rahul-shahtp/Pipelined-32-bit-RISCV-processor/docs/Klayout_view/2.5d_layout.png

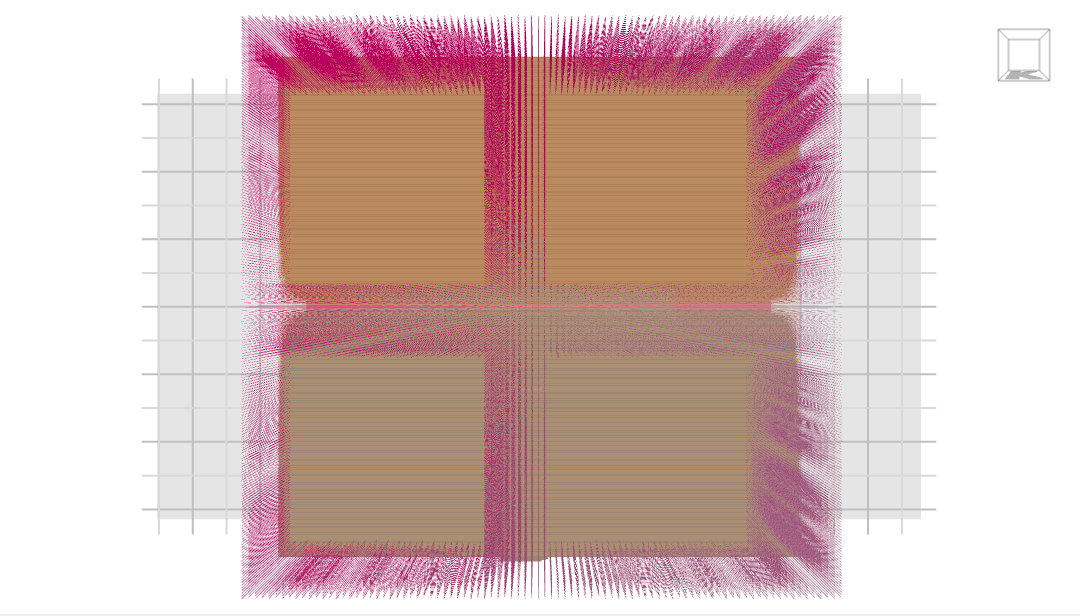
docs/Klayout_view/2.5d_layout.png
