rahul-shahtp/Pipelined-32-bit-RISCV-processor/docs/openROAD_view/layout2.png

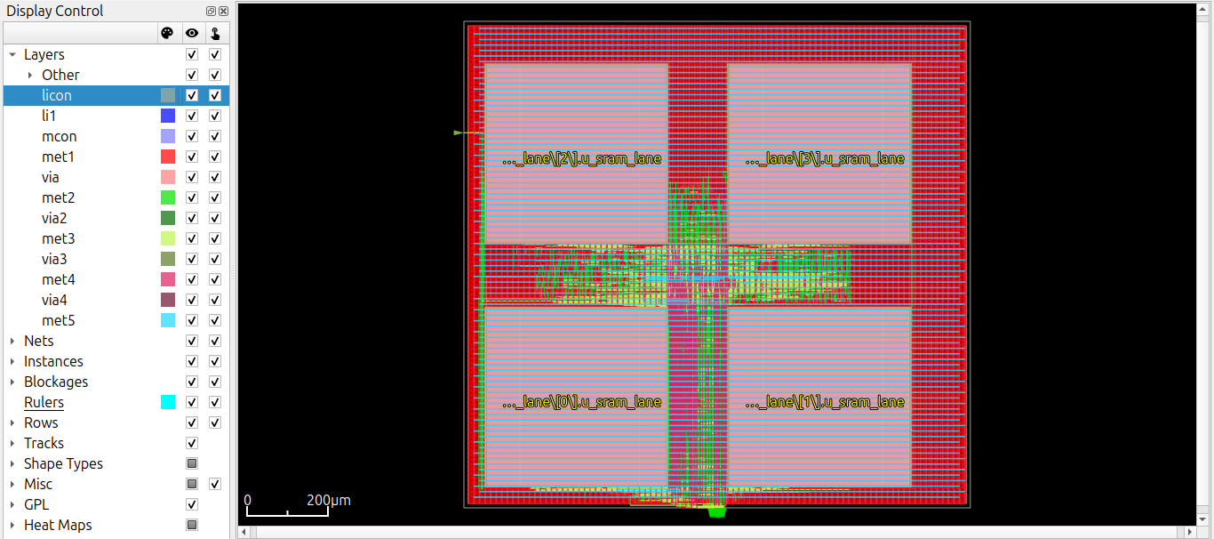
docs/openROAD_view/layout2.png
