rahul-shahtp/Pipelined-32-bit-RISCV-processor/README.md

# Pipelined 32-bit RISC-V (RV32IM) Processor








A complete RTL-to-GDS implementation of a **5-stage pipelined RV32IM core** (RV32I base ISA + M-extension for integer multiplication/division) in Verilog, verified with SystemVerilog testbenches and taken through full physical implementation using the open-source Sky130 PDK.

---

## 📐 Architecture

### Pipeline Stages
| Stage | Function | Key Modules |
|---|---|---|
| **IF** | Instruction Fetch | `pc_reg`, `pc_adder`, `instr_mem`, `if_to_id_reg` |
| **ID** | Decode / Register Read / Hazard Detection | `control_unit`, `register_file`, `imm_gen`, `branch_unit`, `hazard_detection_unit`, `id_to_ex_reg` |
| **EX** | Execute / ALU / Forwarding | `alu`, `alu_control`, `forwarding_unit`, `mul_div_unit`, `ex_to_mem_reg` |
| **MEM** | Memory Access | `data_memory` (4× SRAM macros), `mem_to_wb_reg` |
| **WB** | Writeback | `wb_mux` |

### Key Microarchitectural Features
- **5-stage pipeline** with full bypass/forwarding (ALU operand A & B)
- **Hazard Detection Unit** — load-use stalls (1-cycle bubble)
- **Branch Unit** — early branch resolution in ID; control flush on mispredict
- **M-Extension** — iterative multiplier/divider (`mul_div_unit`) with `mul`, `mulh`, `mulhu`, `div`, `divu`, `rem`, `remu`
- **Byte/Halfword/Word Load-Store** — `LB/LH/LBU/LHU/SB/SH/SW` with sign/zero extension
- **JAL/JALR** — link register support with PC+4 writeback
- **SRAM Integration** — 4× `sky130_sram_1kbyte_1rw1r_8x1024_8` macros (4 KB total, 1 per byte lane)

---

## 🛠 Tools Used

| Category | Tools |
|---|---|
| **Simulation** | Icarus Verilog, GTKWave |
| **Synthesis** | Yosys (Sky130 standard cells) |
| **SRAM Compiler** | OpenRAM (via Sky130 `sky130_sram_macros`) |
| **Physical Implementation** | OpenROAD (floorplan → placement → CTS → routing) |
| **PDK** | Sky130A (sky130_fd_sc_hd + sky130_sram_macros) |
| **Sign-off / View** | Magic, KLayout |

---

## ✅ Verification

SystemVerilog testbench (`tb/rv32im_top_tb.sv`) with **16/16 regression tests passing**:

| Test | Coverage |
|---|---|
| `test_rtype` | ADD, SUB, AND, OR, XOR, SLT, SLTU, SLL, SRL, SRA |
| `test_itype` | ADDI, ANDI, ORI, XORI, SLTI, SLTIU, SLLI, SRLI, SRAI |
| `test_loadstore` | LB, LH, LBU, LHU, SB, SH, SW |
| `test_branch_taken_nottaken` | BEQ, BNE, BLT, BGE, BLTU, BGEU |
| `test_branch_after_alu` | Branch immediately after ALU op (forwarding) |
| `test_load_use` | Load-use stall (1-cycle bubble) |
| `test_raw_back2back` | Back-to-back RAW hazards |
| `test_raw_one_gap` | RAW with one instruction gap |
| `test_jal_jalr` | JAL, JALR with link register |
| `test_lui_auipc` | LUI, AUIPC |
| `test_mul` | MUL, MULH, MULHU |
| `test_div` | DIV, DIVU, REM, REMU (edge cases: div by 0, overflow) |
| `test_x0_writeignore` | x0 hardwired to zero |
| `test_factorial` | Recursive factorial (stress) |
| `test_fibonacci` | Iterative Fibonacci (stress) |
| `test_stress_mixed` | Mixed instruction stream |

Run locally:
```bash
iverilog -g2012 -o sim.out tb/rv32im_top_tb.sv rtl/**/*.v
vvp sim.out
gtkwave dump.vcd
```

---

## 🏗 Physical Implementation

**Flow**: `flow.tcl` (OpenROAD) — synthesis → floorplan → placement → CTS → routing

```bash
# Synthesis (Yosys)
yosys synth_out/sky130_synth.ys

# PnR (OpenROAD)
openroad -no_init -exit flow.tcl
```

### Results

| Metric | Value |
|---|---|
| **Die Area** | 1.5 mm² (1250 × 1200 µm) |
| **Core Utilization** | 62% |
| **Total Instances** | 18,759 (incl. 4 SRAM macros, 8,160 tapcells, 866 endcaps, 290 CTS buffers) |
| **Total Wirelength** | 457k µm |
| **Metal Usage** | met1: 172k, met2: 199k, met3: 50k, met4: 35k, met5: 0.9k µm |
| **Clock Period** | 10 ns (100 MHz target) |
| **WNS (TT, 25°C, 1.8V)** | −2.29 ns |
| **TNS** | −12.6 ns |
| **DRC Violations** | 0 |
| **LVS** | Not yet run |

> **Note on Timing**: Negative WNS (−2.29 ns) indicates setup violations at 100 MHz. This is a physical implementation detail — the processor is functionally correct (16/16 tests pass in simulation). Since this project targets RTL-to-GDS flow exploration rather than physical tapeout, the clock period could be relaxed to ~13 ns (77 MHz) or RTL retiming applied (e.g., moving branch resolution from ID to EX stage).

---

## 🧠 SRAM Macros (OpenRAM)

The data memory is built from **4 × `sky130_sram_1kbyte_1rw1r_8x1024_8`** macros — one per byte lane (4 KB total). These macros are generated by [**OpenRAM**](https://github.com/VLSIDA/OpenRAM), the open-source SRAM compiler. Pre-compiled copies ship with the Sky130 PDK under `sky130_sram_macros`, so no local OpenRAM run is needed to reproduce this flow.

| Property | Value |
|---|---|
| **Macro** | `sky130_sram_1kbyte_1rw1r_8x1024_8` |
| **Organization** | 1024 words × 8-bit (1 KB) |
| **Ports** | 1RW port + 1R port (1RW1R), write mask |
| **Instances** | 4 — one per byte lane of `data_memory` |

### How the macros enter the flow
1. **RTL** — `rtl/mem_stage/sram_1kbyte_1rw1r_8x1024_8_bb.v` provides an empty `(* blackbox *)` model whose pins exactly match the macro LEF (`addr0/addr1`, `din0`, `dout0/dout1`, `csb0/csb1`, `web0`, `wmask0`, `clk0/clk1`, `vccd1/vssd1`).
2. **Synthesis** — Yosys keeps the module as a blackbox; no internal netlist is synthesized.
3. **Place & Route** — `flow.tcl` reads the macro LEF and TT timing lib from the PDK (`libs.ref/sky130_sram_macros/{lef,lib}/…`), then OpenROAD binds the 4 instances to the LEF macro and places them with halos.

### Regenerating macros with OpenRAM (optional)
Only needed if you want a different size/org/port configuration:
```bash
git clone https://github.com/VLSIDA/OpenRAM && cd OpenRAM
# install per repo instructions, then run with a sky130 config file:
openram.py myconfig_sky130.py   # emits .v / .lib / .lef / .gds / .sp
```

---

## 📁 Repository Structure

```
├── ASM/                    # Assembly test programs (.asm)
├── hex/                    # Pre-compiled hex files for simulation
├── rtl/
│   ├── if_stage/           # IF pipeline stage
│   ├── id_stage/           # ID pipeline stage
│   ├── ex_stage/           # EX pipeline stage (ALU, MUL/DIV, forwarding)
│   ├── mem_stage/          # MEM pipeline stage (SRAM, data memory)
│   ├── wb_stage/           # WB pipeline stage
│   └── top/                # Top-level integration (rv32im_top.v, rv32im_asic.v)
├── tb/
│   └── rv32im_top_tb.sv    # SystemVerilog testbench (16 tests)
├── synth/
│   └── sky130_synth.ys     # Yosys synthesis script
├── flow.tcl                # OpenROAD PnR flow script
├── docs/
    ├── design/             # Design documentation
    ├── Klayout_view/       # Layout screenshots
    ├── openROAD_view/      # OpenROAD screenshots
    └── waveforms/          # Simulation waveforms
```
---

## 🚀 How to Run

### Prerequisites
- Icarus Verilog (`iverilog`)
- GTKWave (`gtkwave`)
- Yosys + Sky130 PDK
- OpenROAD + Sky130 PDK
- Magic / KLayout (layout viewing)
- OpenRAM (optional — only to recompile custom SRAM macros)

### Simulation
```bash
# Compile & run all tests
iverilog -g2012 -o sim.out tb/rv32im_top_tb.sv rtl/**/*.v
vvp sim.out

# View waveforms
gtkwave dump.vcd
```

### Synthesis (Yosys)
```bash
cd synth
yosys sky130_synth.ys
# Outputs: synth_out/rv32im_asic_sky130.v, rv32im_asic.sdc
```

### Physical Implementation (OpenROAD)
```bash
export PDK_ROOT=/path/to/pdk
openroad -no_init -exit flow.tcl
# Outputs in results/: .def, _route.v, .sdc, .db, timing/area/power reports
```

---

## 🔮 Future Work
- **AI Accelerator Extension** — integrate a systolic-array MAC coprocessor for matrix multiply, connected via memory-mapped I/O to the RV32IM core

---

## 🔗 Project Links

- **OpenCores:** https://opencores.org/projects/rv32im-pipelined (SVN trunk, tag `v1.0-alpha`, LGPL-3.0)
- **Status:** Alpha — 16/16 tests pass, 0 DRC, WNS open (see [LIMITATIONS.md](LIMITATIONS.md))

---

## 📄 License

Copyright © 2026 Rahul Shah <shahrahul@opencores.org>. Licensed under the **GNU Lesser General Public License v3.0** — see [LICENSE](LICENSE) for details.

### How to Apply These Terms to Source Files

If you contribute to or redistribute this software, attach the following notice to each source file (typically at the top):

```verilog
// Pipelined 32-bit RISC-V (RV32IM) Processor — a five-stage pipelined
// Verilog processor core.
// Copyright (C) 2026 Rahul Shah <shahrahul@opencores.org>
//
// This library is free software; you can redistribute it and/or
// modify it under the terms of the GNU Lesser General Public
// License as published by the Free Software Foundation; either
// version 3 of the License, or (at your option) any later version.
//
// This library is distributed in the hope that it will be useful,
// but WITHOUT ANY WARRANTY; without even the implied warranty of
// MERCHANTABILITY or FITNESS FOR A PARTICULAR PURPOSE.  See the GNU
// Lesser General Public License for more details.
//
// You should have received a copy of the GNU Lesser General Public
// License along with this library; if not, write to the Free Software
// Foundation, Inc., 51 Franklin Street, Fifth Floor, Boston, MA  02110-1301  USA
```
