rahul-shahtp/Pipelined-32-bit-RISCV-processor/docs/design/riscvaddress.png

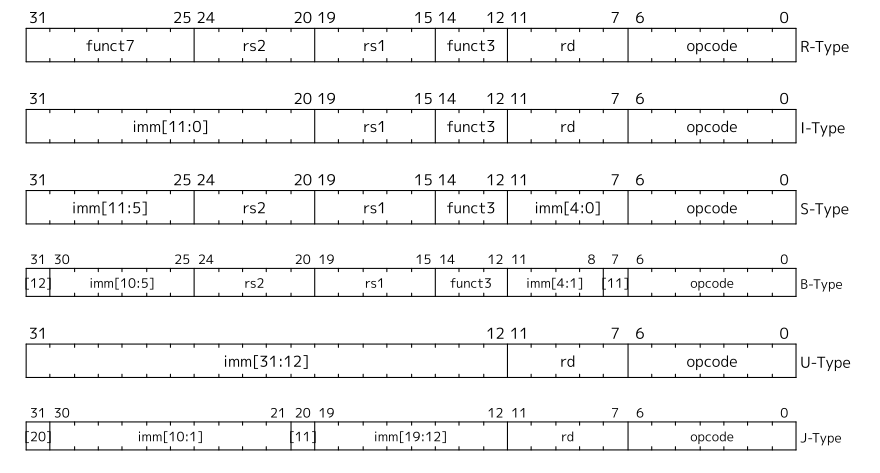
docs/design/riscvaddress.png
