rahul-shahtp/Pipelined-32-bit-RISCV-processor/docs/design/riscvdesign2.png

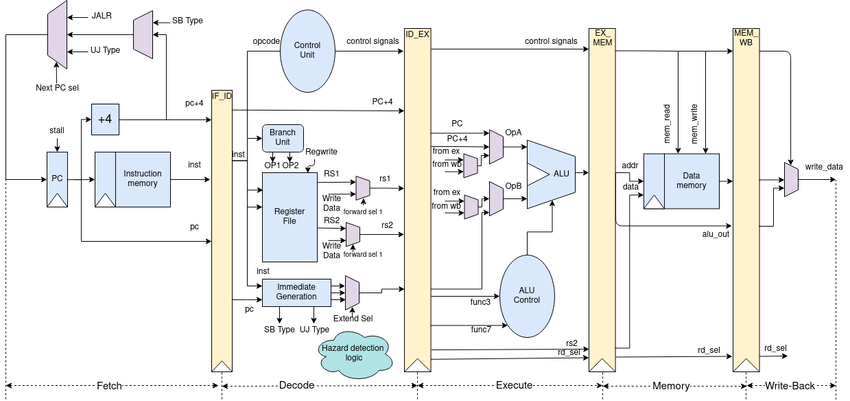
docs/design/riscvdesign2.png
