rahul-shahtp/Pipelined-32-bit-RISCV-processor/docs/design/riscvdesign.png

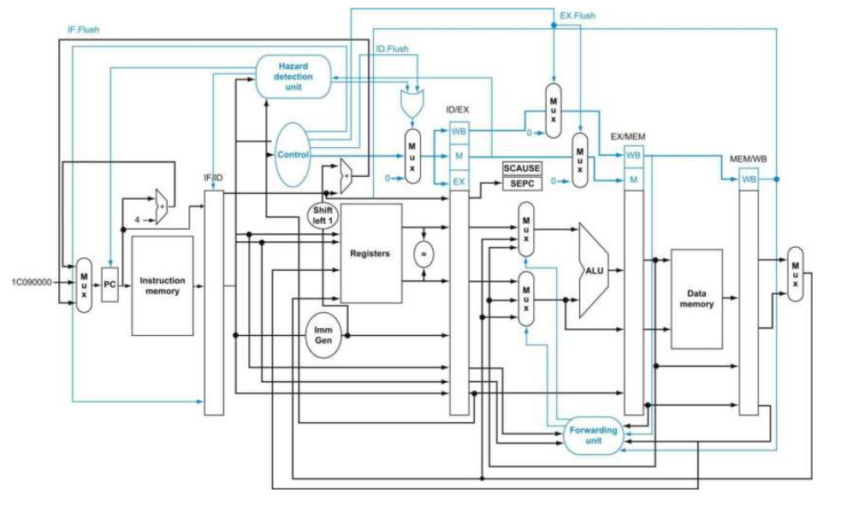
docs/design/riscvdesign.png
