rahul-shahtp/Pipelined-32-bit-RISCV-processor/docs/Klayout_view/full_layout.png

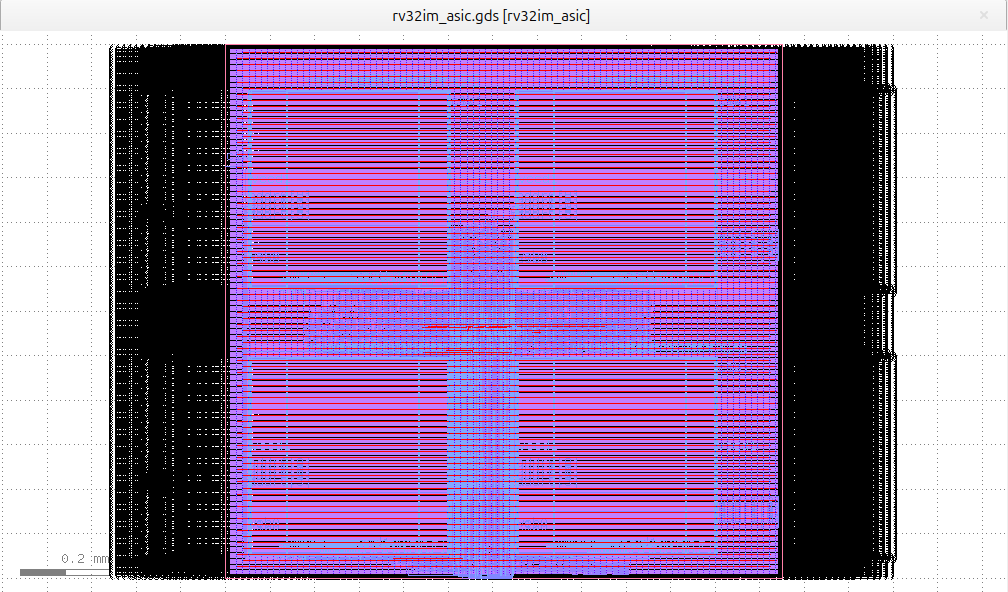
docs/Klayout_view/full_layout.png
