rahul-shahtp/Pipelined-32-bit-RISCV-processor/docs/waveforms/test_branch_after_alu_flush.png

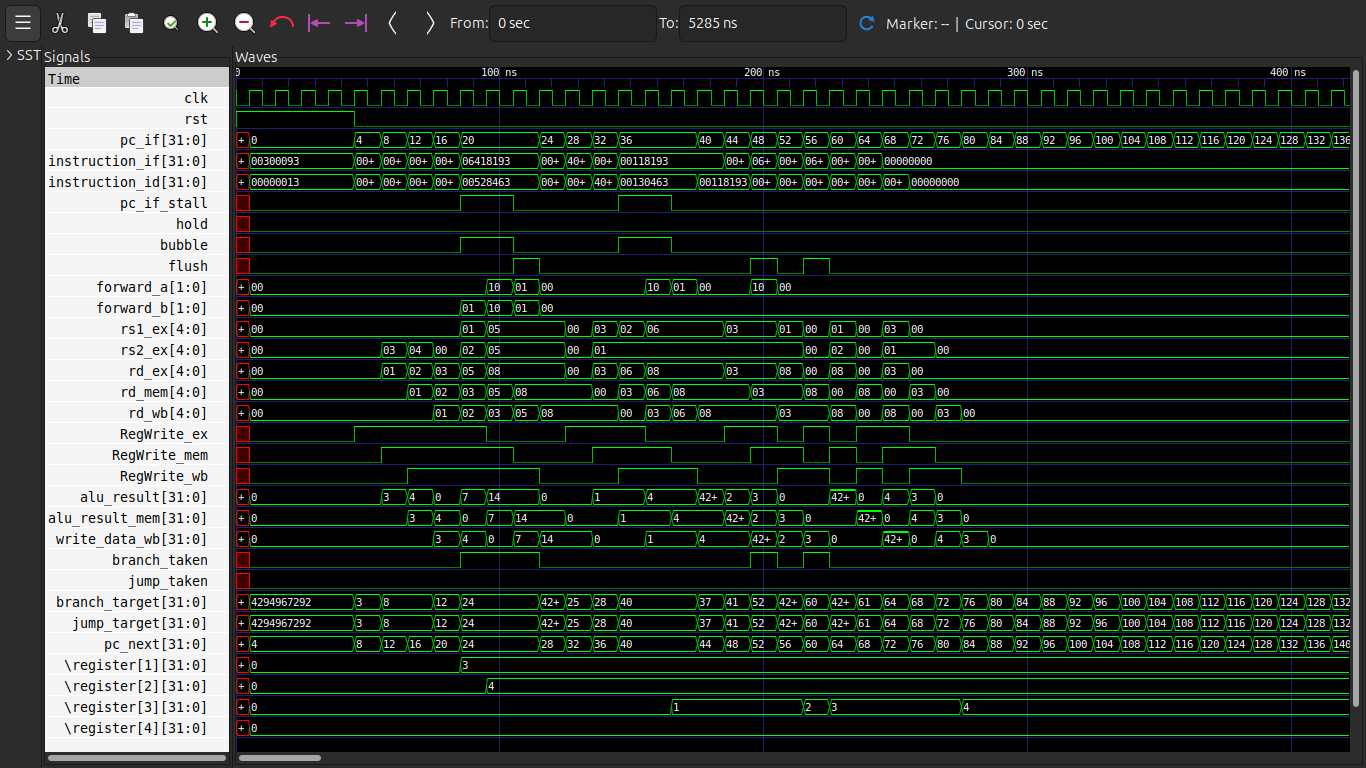
docs/waveforms/test_branch_after_alu_flush.png
