rahul-shahtp/Pipelined-32-bit-RISCV-processor/docs/waveforms/test_fibonacci_forwarding_loop.png

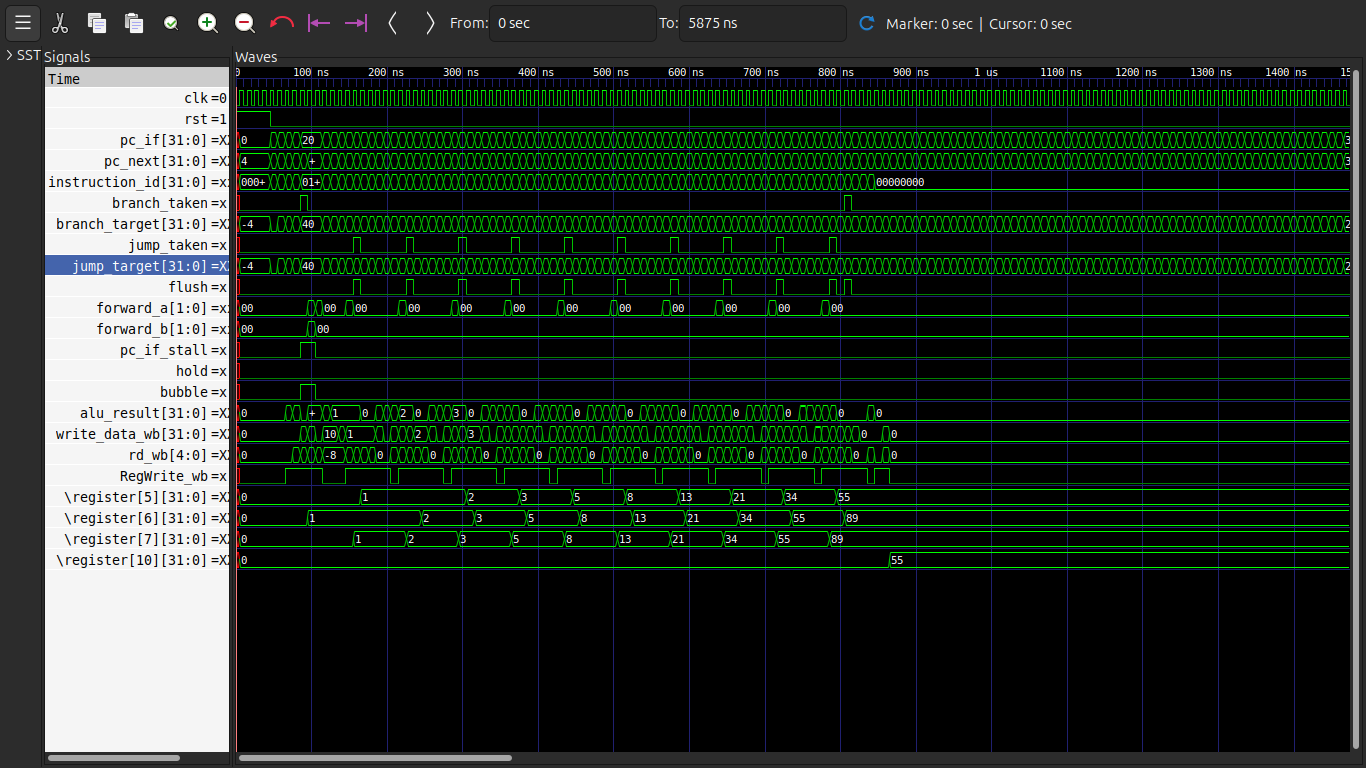
docs/waveforms/test_fibonacci_forwarding_loop.png
