rahul-shahtp/Pipelined-32-bit-RISCV-processor/docs/waveforms/test_jal_jalr_control_flow.png

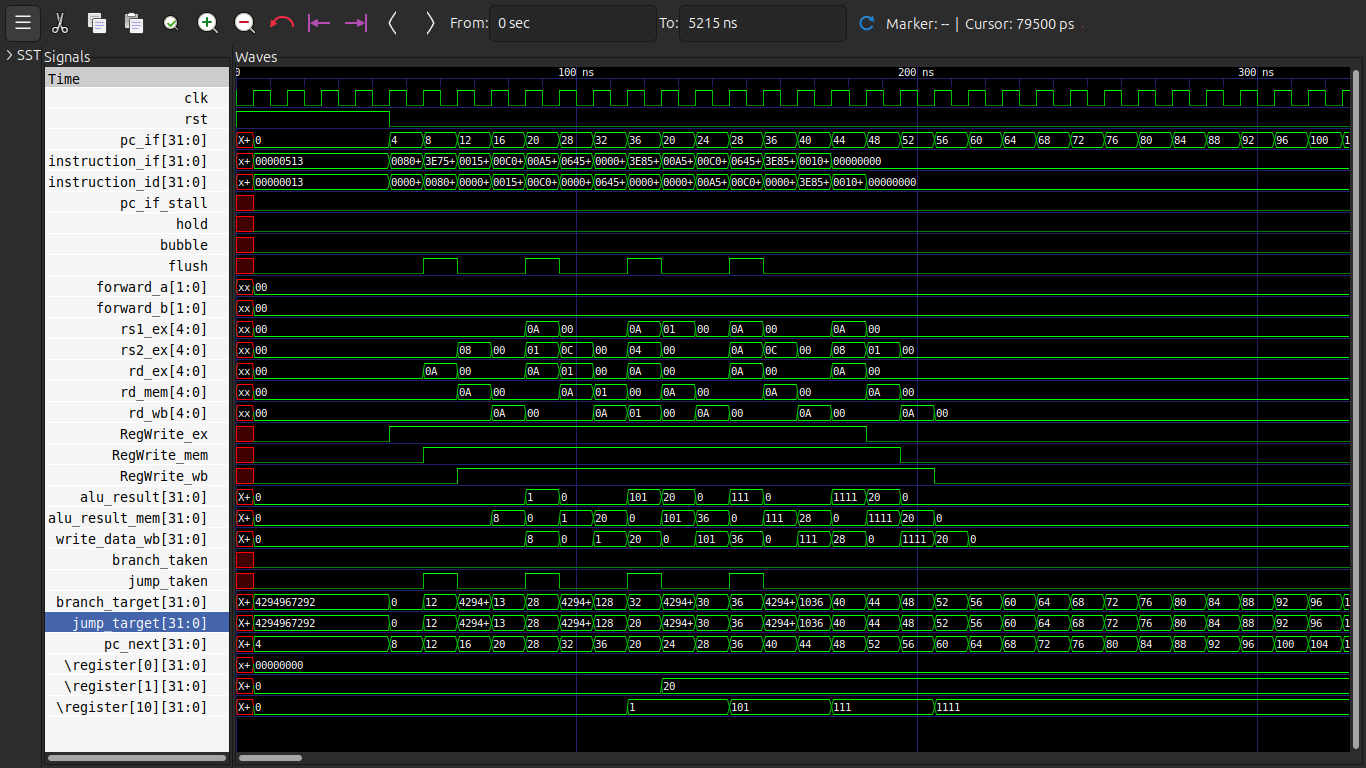
docs/waveforms/test_jal_jalr_control_flow.png
