rahul-shahtp/Pipelined-32-bit-RISCV-processor/docs/waveforms/test_load_use_stall.png

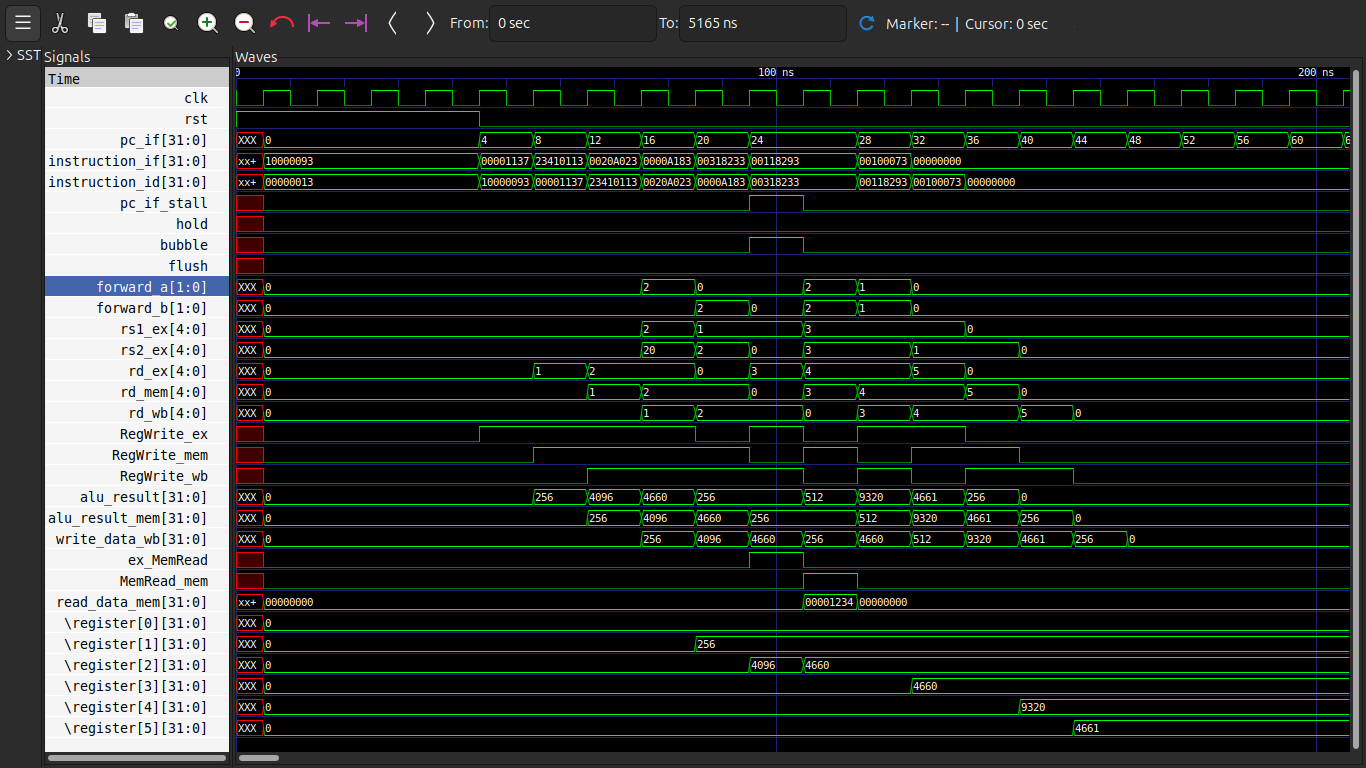
docs/waveforms/test_load_use_stall.png
