rahul-shahtp/Pipelined-32-bit-RISCV-processor/docs/waveforms/test_mul_div_result.png

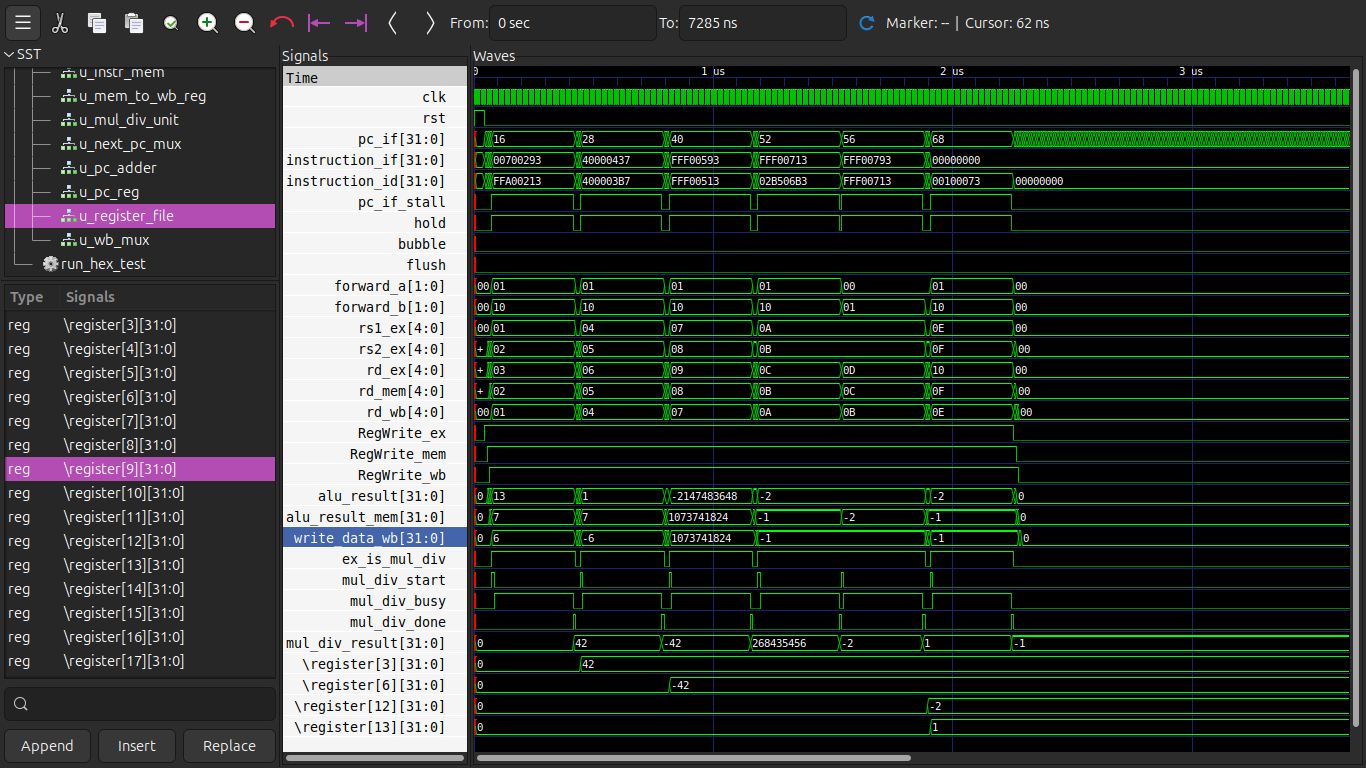
docs/waveforms/test_mul_div_result.png
