rahul-shahtp/Pipelined-32-bit-RISCV-processor/docs/waveforms/test_raw_back2back_forwarding.png

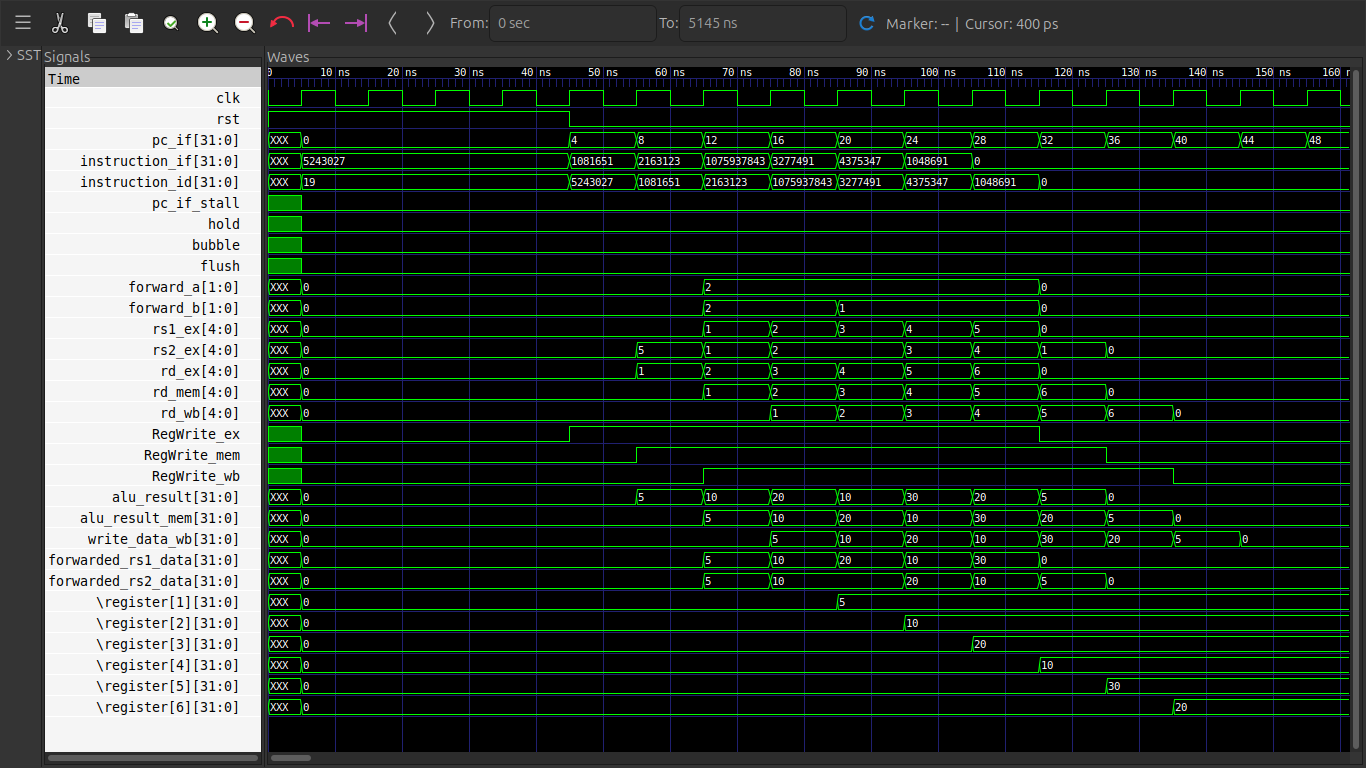
docs/waveforms/test_raw_back2back_forwarding.png
