rahul-shahtp/Pipelined-32-bit-RISCV-processor/docs/design/fullschematic.pdf

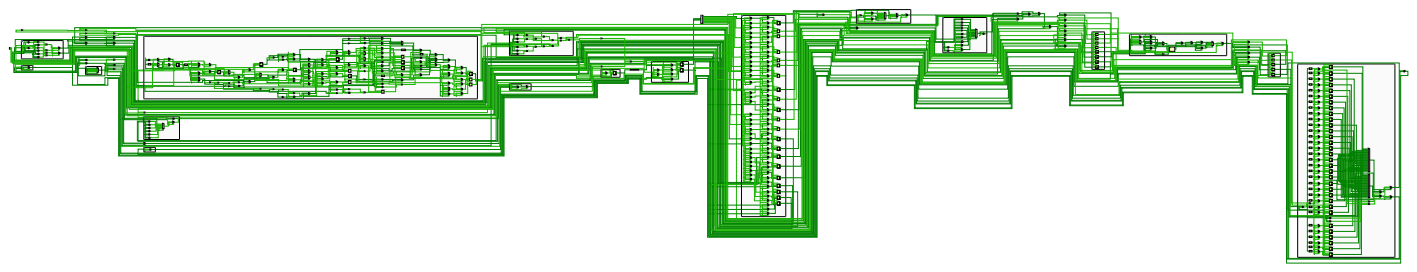
[picture p17: page 1]
u_alu; alu; zero; n/c alu_op[3:0]; alu_result[31:0] operand_a[31:0] operand_b[31:0]; u_alu_control; alu_control; funct7_5thBIT; is_mul_div; is_rtype; ALUopCode[1:0]; alu_op[3:0]; funct3[2:0]; u_branch_unit; branch_unit; branch; branch_taken; branch_target[31:0]; imm[31:0] pc[31:0] rs1_data[31:0] rs2_data[31:0]; u_data_memory; data_memory MemRead MemWrite; clk address[31:0]; read_data[31:0] write_data[31:0]; u_ex_to_mem_reg; ex_to_mem_reg; MemRead_ex; MemRead_mem; MemWrite_ex; MemWrite_mem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

rst start op[2:0] operand_a[31:0] operand_b[31:0]
