rahul-shahtp/Pipelined-32-bit-RISCV-processor/docs/design/schematic.pdf

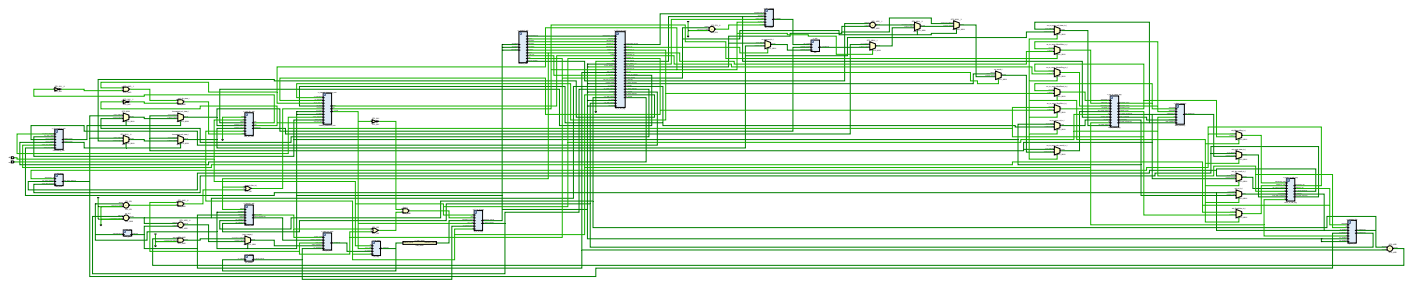
[picture p18: page 1]
clk; rst; RTL_INV__0 RTL_INV; u_forwarding_unit; forwarding_unit; ex_mem_RegWrite mem_wb_RegWrite; ex_mem_rd[4:0]; forward_a[1:0]; forward_b[1:0]; id_ex_rs2[4:0] mem_wb_rd[4:0]; RTL_AND__1 RTL_AND; O RTL_INV__1 RTL_INV; O RTL_MUX RTL_MUX; S=2'b01 I0[31:0] S=default I1[31:0]; O[31:0] S[1:0] RTL_MUX__0 RTL_MUX; O[31:0] S[1:0]=RTL_EQ; RTL_EQO; -pc_id_i RTL_SUB; O[31:0] u_imm_gen; imm_gen; instruction[31:0]; imm[31:0]; mul_div_start_i RTL_AND; forwarded_rs1_data_i RTL_MUX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

ALUopCode[1:0]
ALUsrc MemRead MemWrite MemtoReg RegWrite

u_wb_mux wb_mux MemtoReg_wb alu_result_wb[31:0] read_data_wb[31:0] write_data_wb[31:0]

flush_i RTL_AND I0 I1 O

u_instr_mem
