rahul-shahtp/Pipelined-32-bit-RISCV-processor/rtl/if_stage/instr_mem.v

module instr_mem (
    input  [31:0] address_n,
    output [31:0] instruction_o
);
    localparam MAX_SIZE = 1024 ;
    reg [31:0] memory [0:MAX_SIZE-1];

`ifdef SYNTHESIS
    // ROM contents for synthesis
    initial $readmemh("hex/test_fibonacci.hex", memory);
`endif

    assign instruction_o = memory[address_n[11:2]];

endmodule
