rahul-shahtp/Pipelined-32-bit-RISCV-processor/(commit log)

2026-07-10 Adding ID stage and minor fix
    [control_unit.v, if_to_id_reg.v, instr_mem.v, pc_reg.v, register_file.v]
2026-07-11 extend id stage and minor fix
    [register_file.v]
2026-07-12 complete IF stage
2026-07-12 complete ID stage
2026-07-12 fix minor issue IF stage
2026-07-13 adding EX , MEM , WB stage
2026-07-17 fix clock in if stage
    [if_to_id_reg.v, pc_reg.v, rv32im_top.v]
2026-07-17 fixing bug is hard
    [branch_unit.v, control_unit.v, id_to_ex_reg.v, if_to_id_reg.v, pc_reg.v, register_file.v]
2026-07-18 instantiate IF stage
2026-07-22 Fixing bugs of top module
    [rv32im_top.v, rv32im_top_tb.sv]
2026-07-29 fix negative ADDI value
    [alu_control.v]
2026-07-29 fix correct signed MULH results
    [mul_div_unit.v]
2026-07-29 fix flush in ID to EX reg
    [rv32im_top.v]
2026-07-30 adding HEX file with assembly
2026-08-01 change testbench and add schematic from vivado
2026-08-08 fixing error in top
    [rv32im_top.v]
2026-08-11 fix id to ex reg
    [rv32im_top.v]
2026-08-16 fix SRAM pin name in data memory and blackbox to match LEF macro
    [data_memory.v, sram_1kbyte_1rw1r_8x1024_8_bb.v]
2026-08-16 Adding flow for openroad - 1250x1200 die with 4 SRAM macros
