rahul-shahtp/Pipelined-32-bit-RISCV-processor/(notices)

Notices in the files:
README.md:
License: LGPL-3.0
